hpvdt/propeller_tester/Propellers Test Rig.pdf

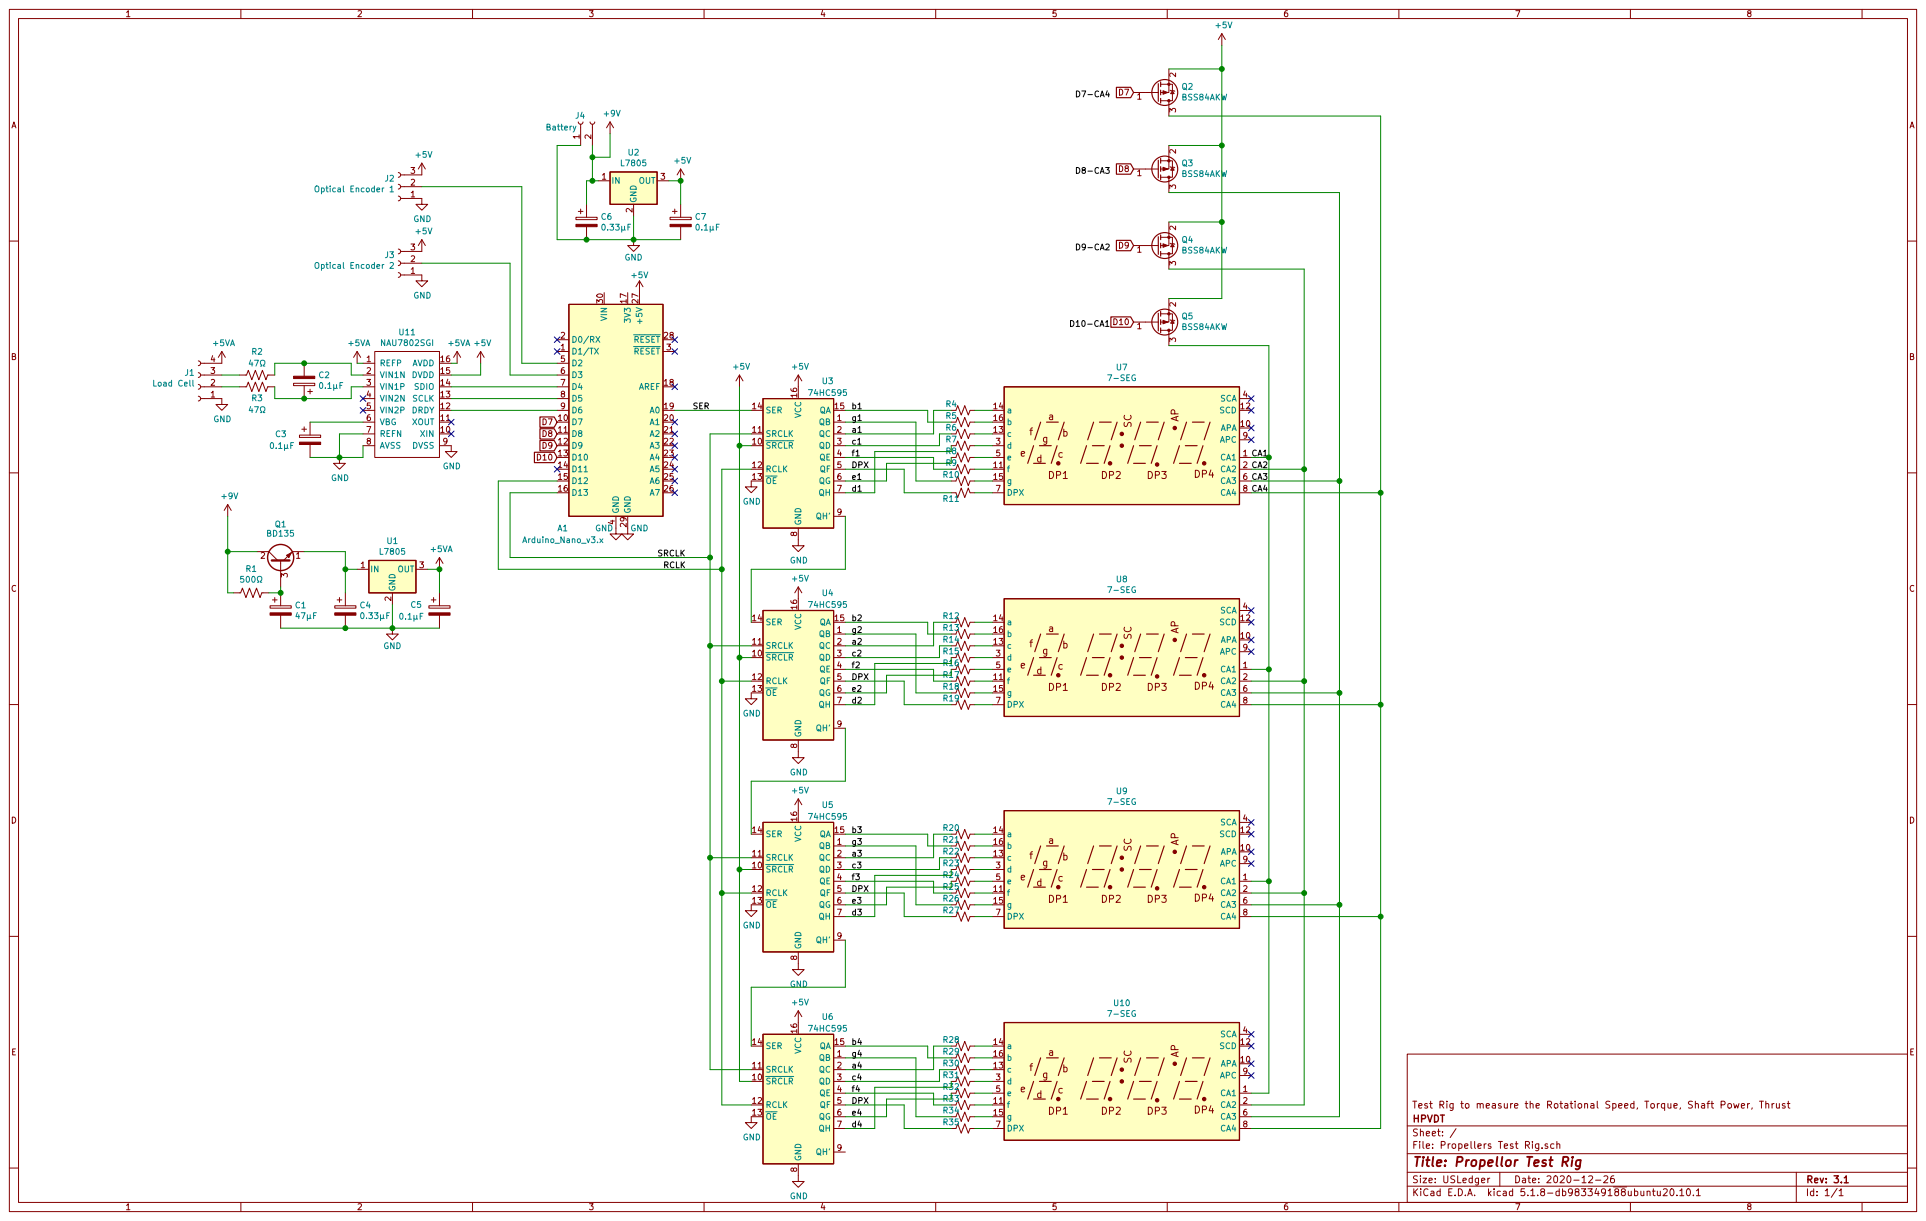
[picture p1: page 1]

DPX
e4

File: Propellers Test Rig.sch Sheet: / HPVDT

Id: 1/1 Title: Propellor Test Rig
