hpvdt/propeller_tester/(commit log)

2021-05-14 Preliminary code for encoders and loadcell
    Preliminary code for these features. Testing, tuning and calibration needs to be done.
2021-05-14 Added board schematic
2021-06-04 Calibration data read in from EEPROM
2021-06-04 Completed the code
    Completed the functionality of this code. Added more information printed for the user, and removed some redundant variables/constants.
2021-06-04 Reminder to add torque formula
2021-06-04 Added physical constants for shaft
2021-06-04 Implemented torque calculation
2021-06-04 Reflecting completion of torque calculation
2021-06-07 Fixes needed for encoder functionality
    [encoder.ino]
2021-06-25 changed torque shaft length to actual length
2021-08-02 Added code for second arduino on shaft
2021-08-02 debugging strain gauge sensor
2021-08-02 just adding some code missing from the previous commit
    [Strain_gauge_module.ino, gauge.ino]
2021-08-02 removed display code to get rid of interrupts
2021-08-15 Added strain gauge constant, but accidentally rolled back the gauge code and now its not working
    [Strain_gauge_module.ino, encoder.h, gauge.ino, loadcell.ino, propeller_tester.ino]
2021-08-15 rolling back to previous gauge code, fingers crossed this works
2021-08-15 Changed number of thicks to 2 and converted torque into float for easier debugging slash more precision
2022-12-17 Create propellor_tester RPM Sensor Code.ino
